djvs/overnumpad_controller_1xb/controller/controller_bom_jlc.csv

Comment | Designator | Footprint | LCSC Part #
100nF | C1,C2,C3,C4,C10,C11,C12,C15,C16,C19 | C_0805_2012Metric_Pad1.15x1.40mm_HandSolder | C49678
10nF | C5 | C_0805_2012Metric_Pad1.15x1.40mm_HandSolder | C1710
1uF | C6,C14,C20 | C_0805_2012Metric_Pad1.15x1.40mm_HandSolder | C28323
4.7uF | C7,C18 | C_0805_2012Metric_Pad1.15x1.40mm_HandSolder | C1779
10pF | C8,C9 | C_0805_2012Metric_Pad1.15x1.40mm_HandSolder | C296083
22uF | C13,C17 | C_0805_2012Metric_Pad1.15x1.40mm_HandSolder | C45783
LED | D1,D2,D3,D4,D5,D6 | LED_0805_2012Metric_Pad1.15x1.40mm_HandSolder | C2296
Ferrite_Bead | FB1 | L_0805_2012Metric_Pad1.15x1.40mm_HandSolder | C1015
Q_PMOS_GSD AO3401A | Q1 | SOT-23 | C700954
Q_NMOS_GSD 2N7002 | Q3,Q2 | SOT-23 | C8545
390 | R1,R16 | R_0805_2012Metric_Pad1.15x1.40mm_HandSolder | C17655
62k | R2,R7,R8,R6,R9,R11,R12,R10 | R_0805_2012Metric_Pad1.15x1.40mm_HandSolder | C17783
47 | R3,R4,R5 | R_0805_2012Metric_Pad1.15x1.40mm_HandSolder | C17714
2k | R13,R14,R15,R18,R17 | R_0805_2012Metric_Pad1.15x1.40mm_HandSolder | C17604
SW_Push | SW1 | switch_K2-1187SQ-A4SW-06 | C92584
AMS1117-3.3 | U1 | SOT-223-3_TabPin2 | C6186
STM32F401RETx | U2 | LQFP-64_10x10mm_P0.5mm | C116978
TPS2553DBVR | U3 | SOT-23-6_Handsoldering | C55266
USBLC6-2SC6 | U4 | SOT-23-6 | C7519
24LC64 | U5 | SOIC-8_3.9x4.9mm_P1.27mm | C79988
8MHz | Y1 | Crystal_SMD_3225-4Pin_3.2x2.5mm_HandSoldering | C389817
Conn_01x04_MountingPin | J5 | JST_SH_SM04B-SRSS-TB_1x04-1MP_P1.00mm_Horizontal | C160404
