djvs/overnumpad_controller_1xb/controller/gerbers/controller-NPTH-drl_map.dxf

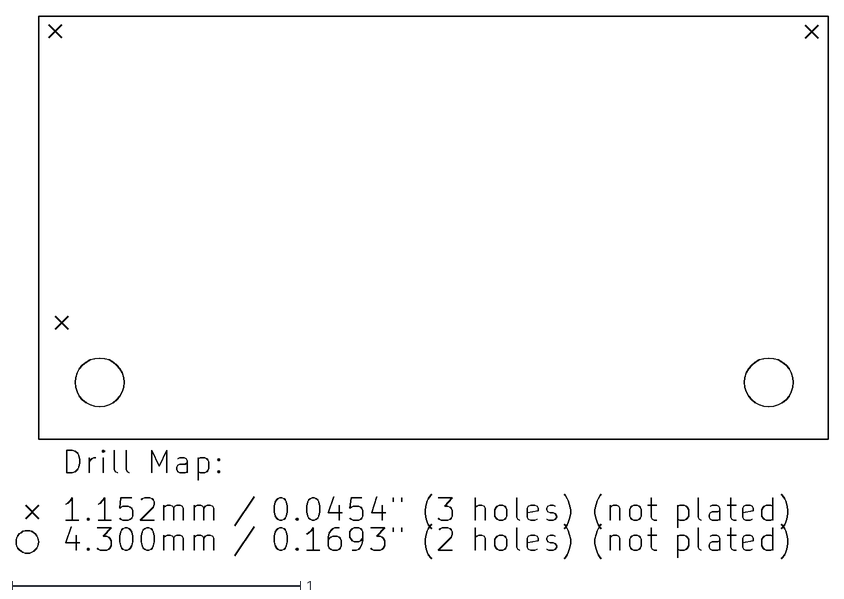
[picture p1: CAD file, 2022-12-28]
controller/gerbers/controller-NPTH-drl_map.dxf
2.82 x 1.88
