djvs/overnumpad_controller_1xb/controller/gerbers/controller-PTH-drl_map.dxf

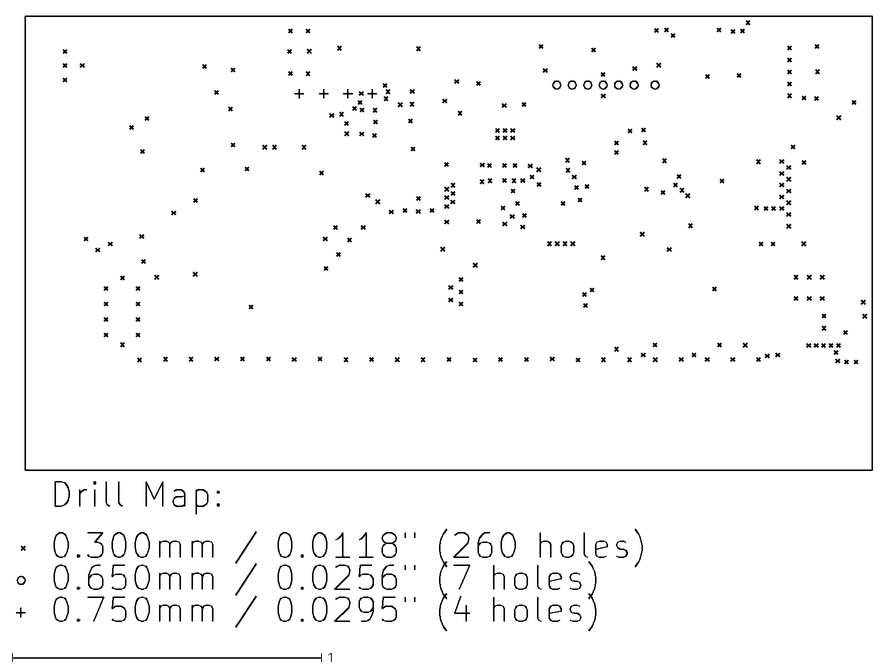
[picture p2: CAD file, 2022-12-28]
controller/gerbers/controller-PTH-drl_map.dxf
2.77 x 1.99
