djvs/overnumpad_controller_1xb/controller/controller.kicad_pcb

## KiCad design controller/controller.kicad_pcb (2022-12-28)

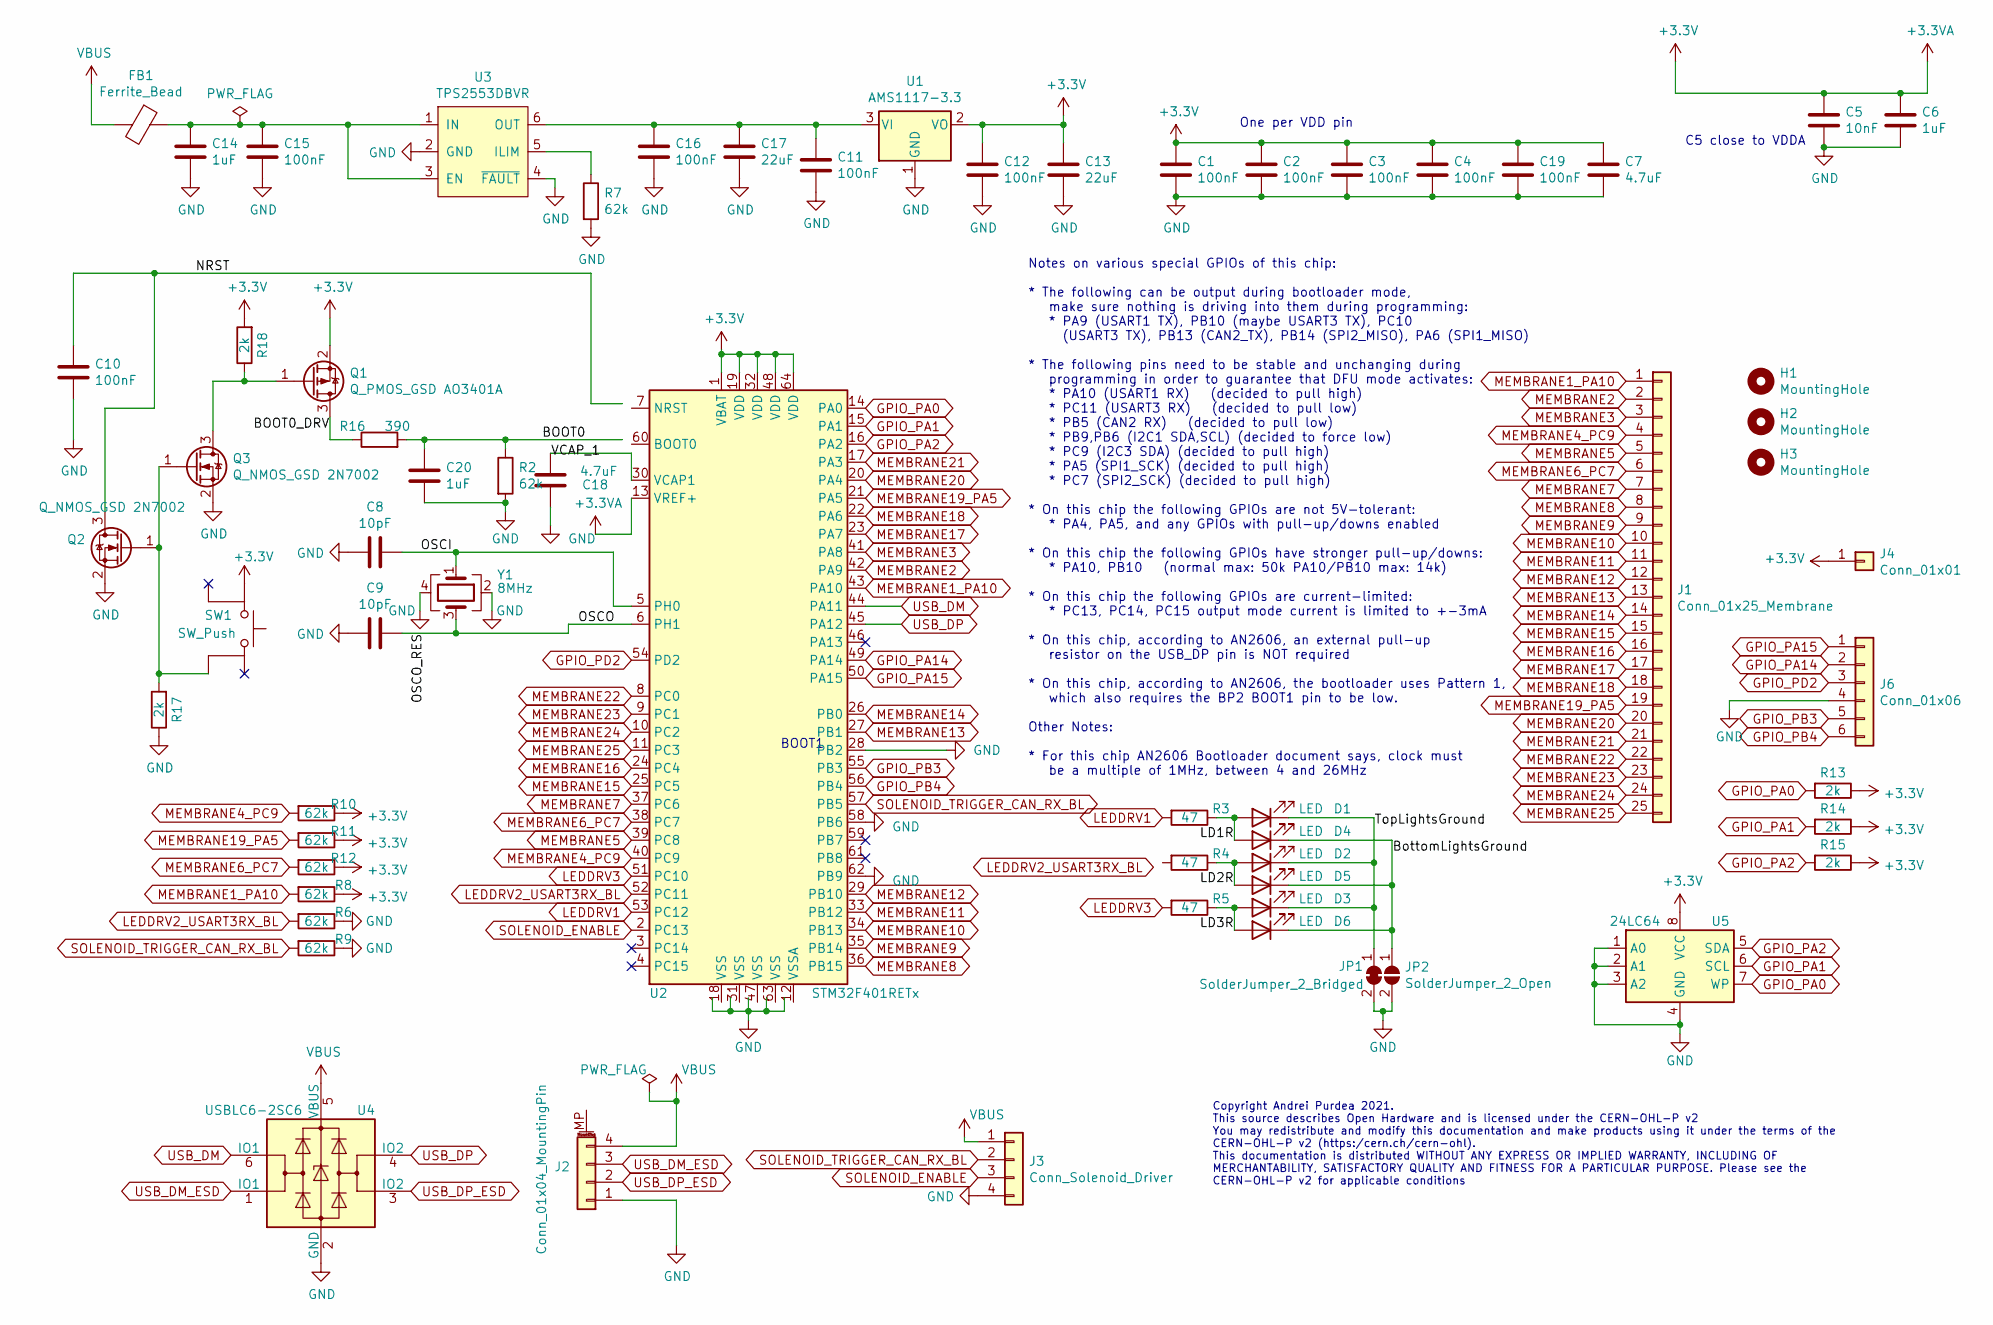
[picture p3: schematic controller.kicad_sch, OverNumpad Controller]

Parts:
C1, C2, C3, C4, C10, C11, C12, C15, C16, C19: 100nF; C_0805_2012Metric_Pad1.15x1.40mm_HandSolder; LCSC C49678
C5: 10nF; C_0805_2012Metric_Pad1.15x1.40mm_HandSolder; LCSC C1710
C6, C14, C20: 1uF; C_0805_2012Metric_Pad1.15x1.40mm_HandSolder; LCSC C28323
C7, C18: 4.7uF; C_0805_2012Metric_Pad1.15x1.40mm_HandSolder; LCSC C1779
C8, C9: 10pF; C_0805_2012Metric_Pad1.15x1.40mm_HandSolder; LCSC C1785
C13, C17: 22uF; C_0805_2012Metric_Pad1.15x1.40mm_HandSolder; LCSC C45783
D1, D2, D3, D4, D5, D6: LED; LED_0805_2012Metric_Pad1.15x1.40mm_HandSolder; LCSC C2296
FB1: Ferrite_Bead; L_0805_2012Metric_Pad1.15x1.40mm_HandSolder; LCSC C1015
H1, H2, H3: MountingHole; tooling_hole
J1: Conn_01x25_Membrane; membrane_connector
J2: Conn_01x04_MountingPin; JST_SH_SM04B-SRSS-TB_1x04-1MP_P1.00mm_Horizontal
J3: Conn_Solenoid_Driver; JST_PH_S4B-PH-K_1x04_P2.00mm_Horizontal
J4: Conn_01x01; PinHeader_1x01_P1.27mm_Vertical_mod_no_courtyard_no_ref
J6: Conn_01x06; PinHeader_1x06_P1.27mm_Vertical
JP1: SolderJumper_2_Bridged; shortable_shorted
JP2: SolderJumper_2_Open; shortable
Q1: Q_PMOS_GSD AO3401A; SOT-23; LCSC C700954
Q2, Q3: Q_NMOS_GSD 2N7002; SOT-23; LCSC C8545
R2, R6, R7, R8, R9, R10, R11, R12: 62k; R_0805_2012Metric_Pad1.15x1.40mm_HandSolder; LCSC C17783
R3, R4, R5: 47; R_0805_2012Metric_Pad1.15x1.40mm_HandSolder; LCSC C17714
R13, R14, R15, R17, R18: 2k; R_0805_2012Metric_Pad1.15x1.40mm_HandSolder; LCSC C17604
R16: 390; R_0805_2012Metric_Pad1.15x1.40mm_HandSolder; LCSC C17655
SW1: SW_Push; switch_K2-1187SQ-A4SW-06; LCSC C92584
U1: AMS1117-3.3; SOT-223-3_TabPin2; LCSC C6186
U2: STM32F401RETx; LQFP-64_10x10mm_P0.5mm; LCSC C69336
U3: TPS2553DBVR; SOT-23-6_Handsoldering; LCSC C55266
U4: USBLC6-2SC6; SOT-23-6; LCSC C15999
U5: 24LC64; SOIC-8_3.9x4.9mm_P1.27mm; LCSC C79988
Y1: 8MHz; Crystal_SMD_3225-4Pin_3.2x2.5mm_HandSoldering; LCSC C389817

Connections:
+3.3VA: C1.1, C2.1, C3.1, C4.1, C5.1, C6.1, C7.1, C12.1, C13.1, C19.1, J4.1, Q1.2 (S), R8.1, R10.1, R11.1, R12.1, R13.1, R14.1, R15.1, R18.2, SW1.1, U1.2 (VO), U2.1 (VBAT), U2.13 (VREF+), U2.19 (VDD), U2.32 (VDD), U2.48 (VDD), U2.64 (VDD), U5.8 (VCC)
/BOOT0: C20.1, R2.1, R16.2
/BOOT0_DRV: Q1.3 (D), R16.1
/BottomLightsGround: D4.1 (K), D5.1 (K), D6.1 (K), JP2.1 (A)
/LD1R: D1.2 (A), D4.2 (A), R3.1
/LD2R: D2.2 (A), D5.2 (A), R4.1
/LD3R: D3.2 (A), D6.2 (A), R5.1
/NRST: C10.2, Q2.3 (D)
/OSCI: C8.1, U2.5 (PH0), Y1.1
/OSCO: C9.1, U2.6 (PH1), Y1.3
/TopLightsGround: D1.1 (K), D2.1 (K), D3.1 (K), JP1.1 (A)
GND: C1.2, C2.2, C3.2, C4.2, C5.2, C6.2, C7.2, C8.2, C9.2, C10.1, C11.2, C12.2, C13.2, C14.2, C15.2, C16.2, C17.2, C18.2, C19.2, C20.2, J3.4, J6.4, JP1.2 (B), JP2.2 (B), Q2.2 (S), Q3.2 (S), R2.2, R6.1, R7.2, R9.1, R17.1, U1.1 (GND), U2.28 (PB2), U2.58 (PB6), U2.62 (PB9), U3.2 (GND), U3.4 (~FAULT), U4.2 (GND), U5.1 (A0), U5.2 (A1), U5.3 (A2), U5.4 (GND), Y1.2, Y1.4; also elsewhere on the board
GPIO_PA0: R13.2, U2.14 (PA0), U5.7 (WP)
GPIO_PA1: R14.2, U2.15 (PA1), U5.6 (SCL)
GPIO_PA2: R15.2, U2.16 (PA2), U5.5 (SDA)
GPIO_PA14: J6.2, U2.49 (PA14)
GPIO_PA15: J6.1, U2.50 (PA15)
GPIO_PB3: J6.5, U2.55 (PB3)
GPIO_PB4: J6.6, U2.56 (PB4)
GPIO_PD2: J6.3, U2.54 (PD2)
LEDDRV1: R3.2, U2.53 (PC12)
LEDDRV2_USART3RX_BL: R6.2, U2.52 (PC11)
LEDDRV3: R5.2, U2.51 (PC10)
MEMBRANE1_PA10: J1.1, R8.2, U2.43 (PA10)
MEMBRANE2: J1.2, U2.42 (PA9)
MEMBRANE3: J1.3, U2.41 (PA8)
MEMBRANE4_PC9: J1.4, R10.2, U2.40 (PC9)
MEMBRANE5: J1.5, U2.39 (PC8)
MEMBRANE6_PC7: J1.6, R12.2, U2.38 (PC7)
MEMBRANE7: J1.7, U2.37 (PC6)
MEMBRANE8: J1.8, U2.36 (PB15)
MEMBRANE9: J1.9, U2.35 (PB14)
MEMBRANE10: J1.10, U2.34 (PB13)
MEMBRANE11: J1.11, U2.33 (PB12)
MEMBRANE12: J1.12, U2.29 (PB10)
MEMBRANE13: J1.13, U2.27 (PB1)
MEMBRANE14: J1.14, U2.26 (PB0)
MEMBRANE15: J1.15, U2.25 (PC5)
MEMBRANE16: J1.16, U2.24 (PC4)
MEMBRANE17: J1.17, U2.23 (PA7)
MEMBRANE18: J1.18, U2.22 (PA6)
MEMBRANE19_PA5: J1.19, R11.2, U2.21 (PA5)
MEMBRANE20: J1.20, U2.20 (PA4)
MEMBRANE21: J1.21, U2.17 (PA3)
MEMBRANE22: J1.22, U2.8 (PC0)
MEMBRANE23: J1.23, U2.9 (PC1)
MEMBRANE24: J1.24, U2.10 (PC2)
MEMBRANE25: J1.25, U2.11 (PC3)
unnamed: Q1.1 (G), Q3.3 (D), R18.1
unnamed: Q2.1 (G), Q3.1 (G), R17.2, SW1.4
unnamed: C11.1, C16.1, C17.1, U1.3 (VI), U3.6 (OUT)
unnamed: C18.1, U2.30 (VCAP1)
unnamed: C14.1, C15.1, FB1.1, U3.1 (IN), U3.3 (EN)
unnamed: R7.1, U3.5 (ILIM)
SOLENOID_ENABLE: J3.3, U2.2 (PC13)
SOLENOID_TRIGGER_CAN_RX_BL: J3.2, R9.2, U2.57 (PB5)
USB_DM: U2.44 (PA11), U4.6 (IO1)
USB_DM_ESD: U4.1 (IO1); also elsewhere on the board
USB_DP: U2.45 (PA12), U4.4 (IO2)
USB_DP_ESD: U4.3 (IO2); also elsewhere on the board
VBUS: FB1.2, J3.1, U4.5 (VBUS); also elsewhere on the board

Notes on the sheet:
C5 close to VDDA
One per VDD pin
Notes on various special GPIOs of this chip: * The following can be output during bootloader mode, make sure nothing is driving into them during programming: * PA9 (USART1 TX), PB10 (maybe USART3 TX), PC10 (USART3 TX), PB13 (CAN2_TX), PB14 (SPI2_MISO), PA6 (SPI1_MISO) * The following pins need to b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
BOOT1
Copyright Andrei Purdea 2021. This source describes Open Hardware and is licensed under the CERN-OHL-P v2 You may redistribute and modify this documentation and make products using it under the terms of the CERN-OHL-P v2 (https:/cern.ch/cern-ohl). This documentation is distributed WITHOUT ANY EXPRE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

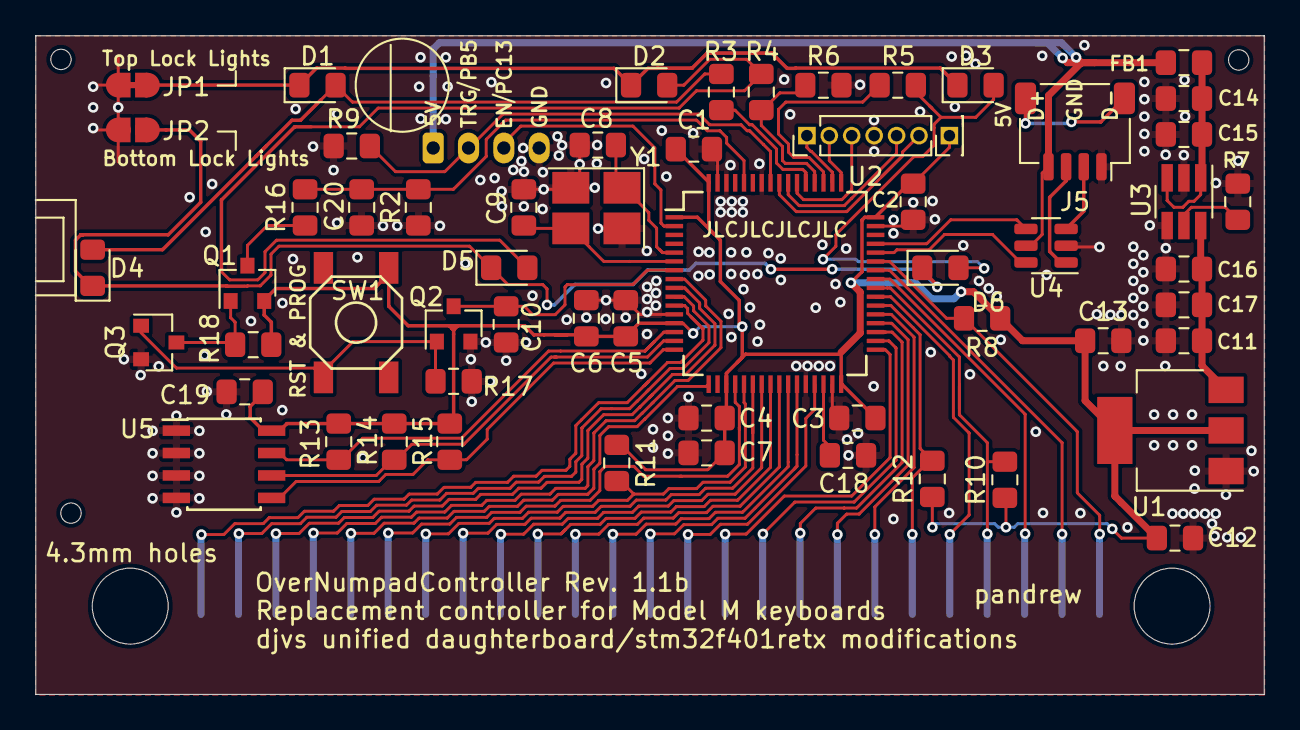
[picture p4: board controller.kicad_pcb from above]

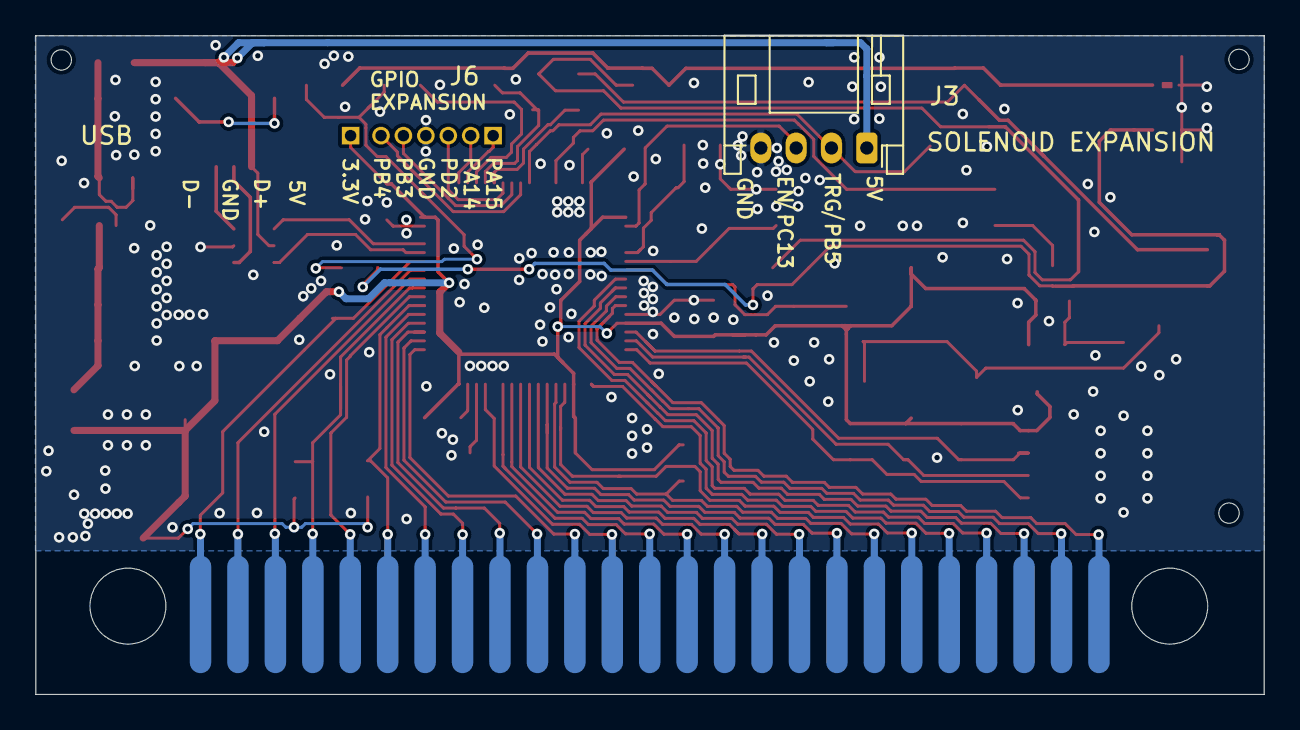
[picture p5: board controller.kicad_pcb from below]

Board: 2 copper layers, 69.6 x 37.3 mm, 64 parts (2 on the bottom side), 61 nets.

Other parts of the board:
J5: Conn_01x04_MountingPin; JST_SH_SM04B-SRSS-TB_1x04-1MP_P1.00mm_Horizontal

Their connections:
GND: J5.1; also elsewhere on the board
USB_DM_ESD: J5.3; also elsewhere on the board
USB_DP_ESD: J5.2; also elsewhere on the board
VBUS: J5.4; also elsewhere on the board
